baobuibk/NANORACK_V2_PHOTODIODE_1.1.2_HW/03_BOM/NANORACK_PHOTODIODE.xlsx

Comment | Description | Designator | Footprint | LibRef | Quantity
470pF/25V | 0603 | C1, C9, C14 | CN-SMD-0603 | CM | 3
0.22uF/25V | 0603 | C2, C5, C6, C7, C8, C10, C11, C12, C13, C15, C16, C17, C18, C20, C21, C22, C25, C27, C28, C31, C32, C33, C34, C35, C36, C37, C38, C39, C40, C41, C42, C43, C44, C45, C46, C47, C173, C213, C215, C219 | CN-SMD-0603 | CM | 40
10nF/25V | 0603 | C3, C4, C19, C26 | CN-SMD-0603 | CM | 4
100uF 16V | Polarized Capacitor (Axial) | C23, C24 | CAP TANT 2312 | CN-ALU-SMD | 2
100uF/16V | Polarized Capacitor (Axial) | C29, C30 | CAP TANT 2312 | CN-ALU-SMD | 2
10uF 16V | Polarized Capacitor (Axial) | C48, C49, C50 | CAP_TANT_1206 | CN-ALU-SMD | 3
S2312 | TVS DIODE 12VWM 19VC SOT23, P/N: S2312 | D1 | SOT23-123 | S2315 | 1
S2305 | TVS DIODE 5VWM 10.8VC SOT23, P/N: S2305 | D2, D3, D4, D5 | SOT23-123 | S2303 | 4
SS54 | DIODE SCHOTTKY 40V 5A SMA | D6 | DIO-SMD-A | Diode SMD | 1
HOLD |  | H1, H2, H3, H4, H5, H6, H7, H8 | M3 - 6mm | PAD_HOLD | 8
0532610971 | WR-PHD 2.54 mm Angled Socket Header | J1 | 0532610971 | JP9 | 1
Conn shunt | WR-PHD 2.54 mm Angled Socket Header | J2 | M50-3930342 | JP3 | 1
JUMP2 |  | JP1 | Jump2 | JUMP2 | 1
15uH/3.5A | SRP7050TA-150M | L1 | SRP7050TA | INDUCTOR | 1
Photodiode |  | PD1, PD2, PD3, PD4, PD5, PD6, PD7, PD8, PD9, PD10, PD11, PD12, PD13, PD14, PD15, PD16, PD17, PD18, PD19, PD20, PD21, PD22, PD23, PD24, PD25, PD26, PD27, PD28, PD29, PD30, PD31, PD32, PD33, PD34, PD35, PD36 | VEMD5080X01 | Photodiode | 36
330k 1% | 0603 | R1 | RES-SMD-0603 | Res-SMD | 1
10K 1% | 0603 | R2, R4, R6, R24, R26 | RES-SMD-0603 | Res-SMD | 5
4.7K 1% | 0603 | R3, R5, R7, R8, R10, R11, R14, R15, R16, R17, R18, R19, R20, R22, R23 | RES-SMD-0603 | Res-SMD | 15
51R 1% | 0603 | R9 | RES-SMD-0603 | Res-SMD | 1
22R 1% | 0603 | R12, R13 | RES-SMD-0603 | Res-SMD | 2
3.24K 0.1% | ERA-3AEB3241V | R25 | RES-SMD-0603 | Res-SMD | 1
2K 1% | 0603 | R27 | RES-SMD-0603 | Res-SMD | 1
Test_Point |  | TP1, TP2, TP3, TP4, TP6, TP7, TP8, TP9, TP10, TP11, TP12, TP13 | TESTPOINT | Test_Point | 12
ADG1414BCPZ | IC SW SPST-NOX8 11.5OHM 24LFCSP | U1, U2, U5, U6, U7, U8 | ADG1414BCPZ | ADG1414 | 6
OPA4340 | IC CMOS 4 CIRCUIT 16SSOP | U3 | SSOP16 | OPA4340 | 1
REF1930 | REF1941AIDDCT | U4 | SOT23-5 | REF19xx | 1
TPS5430DDAR | 8SOP | U9 | HSOP8 | TPS543X | 1
ADS8327 | IC ADC 16BIT SAR 16TSSOP | U10 | TSSOP16 | ADS8327 | 1
ICL7660 | CMOS Voltage Converters | U11 | SO8 | ICL7660 | 1
TPS7A4533DCQR | IC REG LINEAR 3.3V 1.5A SOT223-6 | U12 | SOT223-6 | TPS7A4533DCQR | 1
