baobuibk/NANORACK_V2_PHOTODIODE_1.1.2_HW/03_BOM/PHOTODIODE_BOM_V1.2.0.xlsx

Name/Comment | Description | Designator | Footprint | Manufacturer | Manufacturer P/N | Quantity | NOTE | STATUS
10uF/16V | CAP TANT 10UF 10% 16V 1206 | C48, C49, C50 | 1206 | KYOCERA AVX | TAJA106K016RNJ | 3
100uF/16V | CAP TANT 100UF 10% 16V 2312 | C23, C24, C29, C30 | 2312 | KYOCERA AVX | TAJC107K016RNJ | 4
10nF/16V | CAP CER 10NF 16V X7R 0603 | C3, C4, C19, C26 | SM-0603 | Samsung Electro-Mechanics | CL10B103KO8WPNC | 4
470pF/50V | CAP CER 470PF 50V X7R 0603 | C1, C9, C14 | SM-0603 | Samsung Electro-Mechanics | CL10B471KB8NNNC | 3
0.22uF 25V | CAP CER 0.22UF 25V X7R 0603 | C2, C5, C6, C7, C8, C10, C11, C12, C13, C15, C16, C17, C18, C20, C21, C22, C25, C27, C28, C31, C32, C33, C34, C35, C36, C37, C38, C39, C40, C41, C42, C43, C44, C45, C46, C47, C173, C213, C215, C219 | SM-0604 | Samsung Electro-Mechanics | CL10B224KO8NNNC | 40
OPA4340 | IC CMOS 4 CIRCUIT 16SSOP | U3 | SSOP16 | Texas Instruments | OPA4340EA/2K5 | 1
REF1930 | IC VREF SERIES 0.1% SOT23-5 | U4 | SOT23-5 | Texas Instruments | REF1930AIDDCT | 1
ADS8327 | IC ADC 16BIT SAR 16TSSOP | U10 | TSSOP16 | Texas Instruments | ADS8327IPW | 1
Photodiode | SENSOR PHOTODIODE 950NM 4SMD | PD1, PD2, PD3, PD4, PD5, PD6, PD7, PD8, PD9, PD10, PD11, PD12, PD13, PD14, PD15, PD16, PD17, PD18, PD19, PD20, PD21, PD22, PD23, PD24, PD25, PD26, PD27, PD28, PD29, PD30, PD31, PD32, PD33, PD34, PD35, PD36 | PS13-6B TO | Vishay Semiconductor Opto Division | VEMD5080X01 | 36
330k 1% | RES SMD 330K OHM 1% 1/10W 0603 | R1 | RES-SMD-0603 | Panasonic Electronic Components | ERJ-3EKF3303V | 1
51R 1% | RES SMD 51 OHM 1% 1/10W 0603 | R9 | RES-SMD-0603 | Panasonic Electronic Components | ERJ-3EKF51R0V | 1
4.7k 1% | RES SMD 4.7K OHM 1% 1/10W 0603 | R3, R5, R7, R8, R10, R11, R14, R15, R16, R17, R18, R19, R20, R22, R23 | RES-SMD-0603 | Panasonic Electronic Components | ERJ-3EKF4701V | 15
10K 1% | RES SMD 10K OHM 1% 1/10W 0603 | R2, R4, R6, R24, R26 | RES-SMD-0603 | Panasonic Electronic Components | ERJ-3EKF1002V | 5
22R 1% | RES SMD 22 OHM 1% 1/10W 0603 | R12, R13 | RES-SMD-0603 | Panasonic Electronic Components | ERJ-3EKF22R0V | 2
2K 1% | RES SMD 2K OHM 1% 1/10W 0603 | R27 | RES-SMD-0603 | Panasonic Electronic Components | ERJ-3EKF2001V | 1
S2312 | TVS DIODE 12VWM 19VC SOT23 | D1 | SOT23-123 | SMC Diode Solutions | S2312 | 1
S2303 | TVS DIODE 5VWM 8VC SOT23, P/N: S2303 | D2, D3, D4, D5 | SOT23-123 | SMC Diode Solutions | S2303 | 4
TPS7A4533DCQR | IC REG LINEAR 3.3V 1.5A SOT223-6 | U12 | SOT223 | Texas Instruments | TPS7A4533DCQR | 1
SS54 | DIODE SCHOTTKY 40V 5A SMA | D6 | DIO-SMD-A | EVVO | SS54 | 1
15uH/3.5A | FIXED IND 15UH 3.5A 92 MOHM SMD | L1 | SRP7050TA | Bourns Inc. | SRP7050TA-150M | 1
3.24K 0.1% | RES SMD 3.24K OHM 1% 1/10W 0603 | R25 | RES-SMD-0603 | Panasonic Electronic Components | ERJ-3EKF3241V | 1
ADG1414BCPZ | IC SW SPST-NOX8 11.5OHM 24LFCSP | U1, U2, U5, U6, U7, U8 | ADG1414BCPZ | Analog Devices Inc. | ADG1414BCPZ | 6
TPS5430DDAR | IC REG BUCK ADJ 3A 8SOPWR | U9 | HSOP8 | Texas Instruments | TPS5430DDAR | 1
CONNECTOR | CONN HEADER SMD R/A 9POS 1.25MM | J1 | JP9 | Molex | 0532610971 | 1
CONN_SHUNT | CONN HEADER R/A 3POS 1.27MM | J2 |  | Harwin Inc. | M50-3930342 | 1
ICL7660 | IC REG CHARG PUMP INV 45MA 8SOIC | U11 | SO8 | Renesas Electronics Corporation | ICL7660ACBAZA-T | 1
M50-1900005 | CONN SHUNT 1.27MM BLACK |  |  | Harwin Inc. | M50-1900005 | 1 | Mating
0510210900 | CONN RCPT HSG 9POS 1.25MM |  |  | Molex | 0510210900 | 1 | Mating for J1
0500798000 | CONN SOCKET 26-28AWG CRIMP TIN |  |  | Molex | 0500798000 | 9 | Cos for mating J1
 |  |  |  |  |  | 137
