baobuibk/NANORACK_V2_PHOTODIODE_1.1.2_HW/02_SCHEMATIC_PDF/NANORACK_PHOTODIODE.pdf

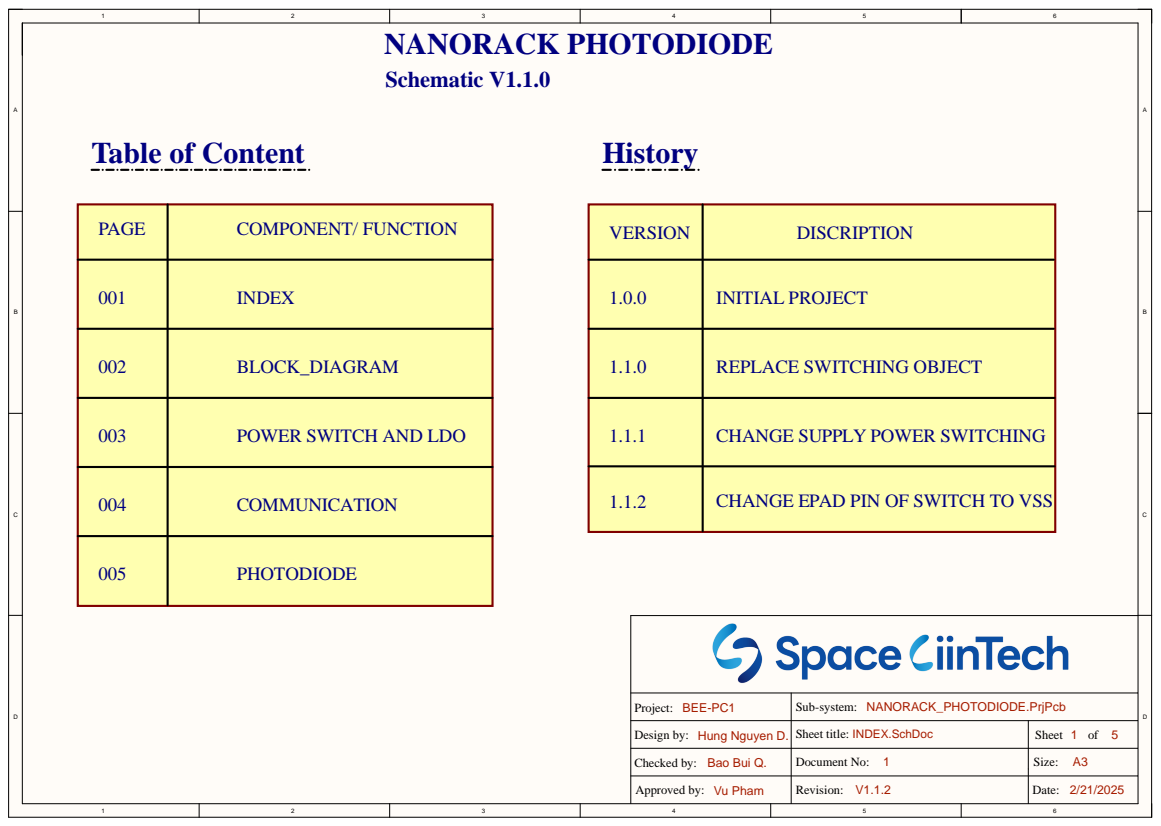
[picture p1: page 1]

POWER SWITCH AND LDO

CHANGE SUPPLY POWER SWITCHING

Project: BEE-PC1 | NANORACK_PHOTODIODE.PrjPcb Sub-system:

Design by: Hung Nguyen D. | Sheet title: INDEX.SchDoc | Sheet 1 of 5

Checked by: Bao Bui Q. | Document No: 1 | Size: A3

Approved by: Vu Pham | Revision: V1.1.2 | Date: 2/21/2025

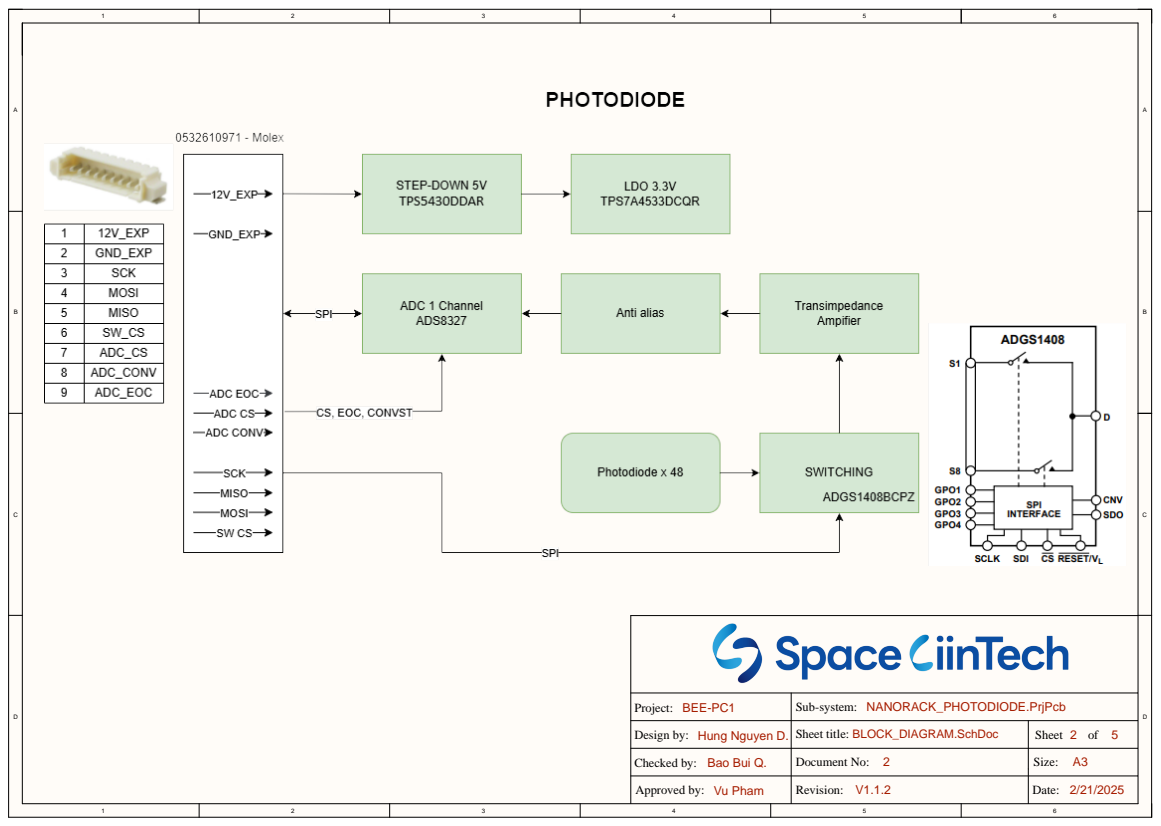
[picture p2: page 2]

Project: BEE-PC1 | NANORACK_PHOTODIODE.PrjPcb Sub-system:

Design by: Hung Nguyen D. | Sheet title: BLOCK_DIAGRAM.SchDoc | Sheet 2 of 5

Checked by: Bao Bui Q. | Document No: 2 | Size: A3

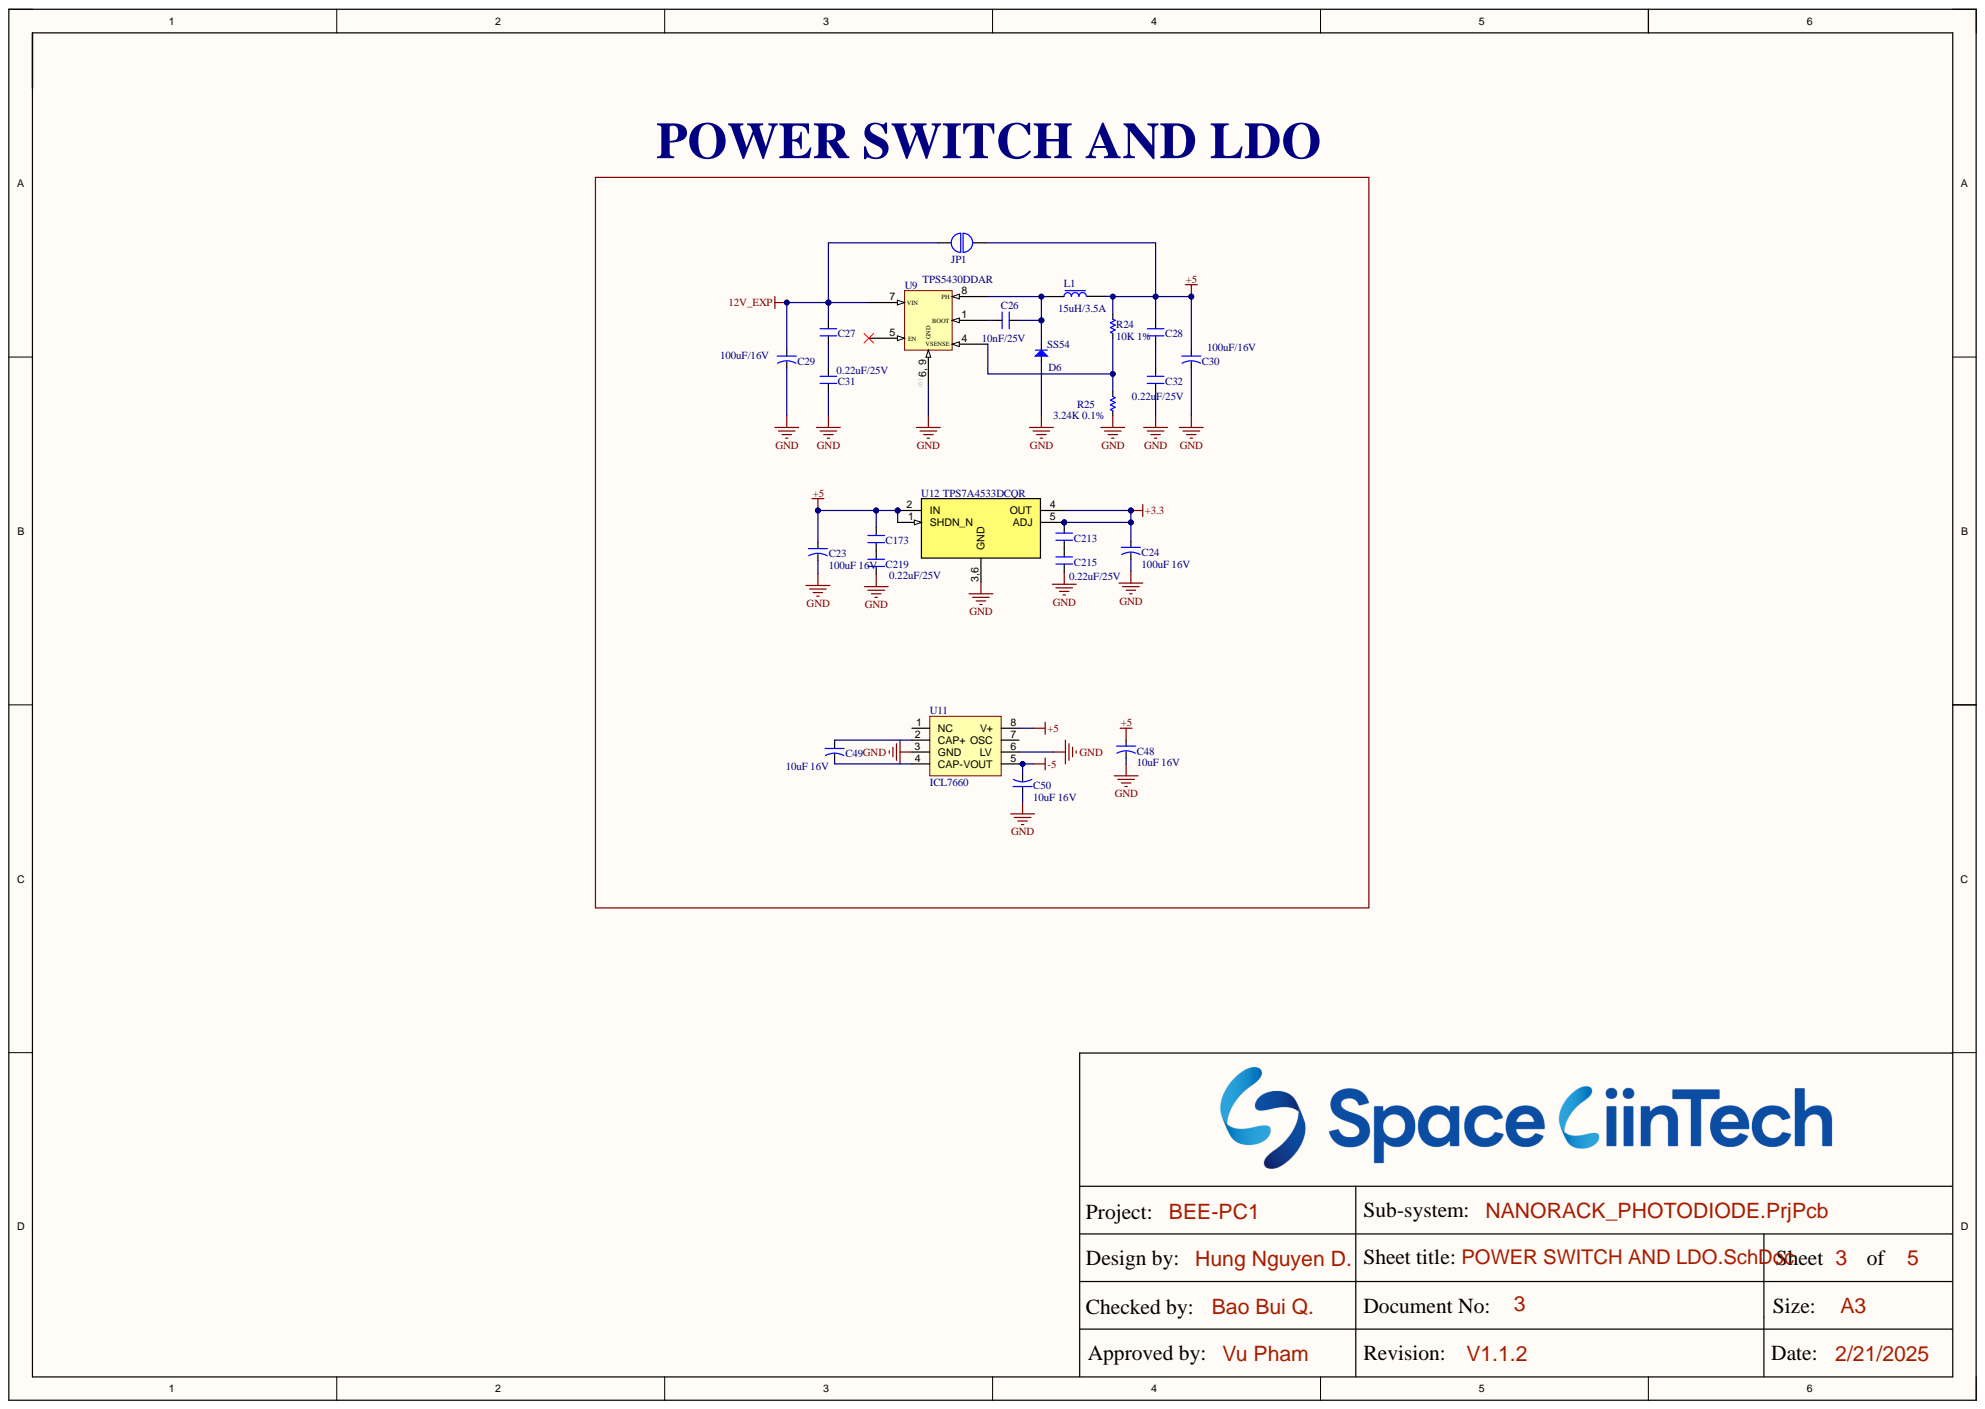
[picture p3: page 3]

POWER SWITCH AND LDO

Project: BEE-PC1 | NANORACK_PHOTODIODE.PrjPcb Sub-system:

Design by: Hung Nguyen D. | Sheet title: POWER SWITCH AND LDO.SchDoc | Sheet 3 of 5

Checked by: Bao Bui Q. | Document No: 3 | Size: A3

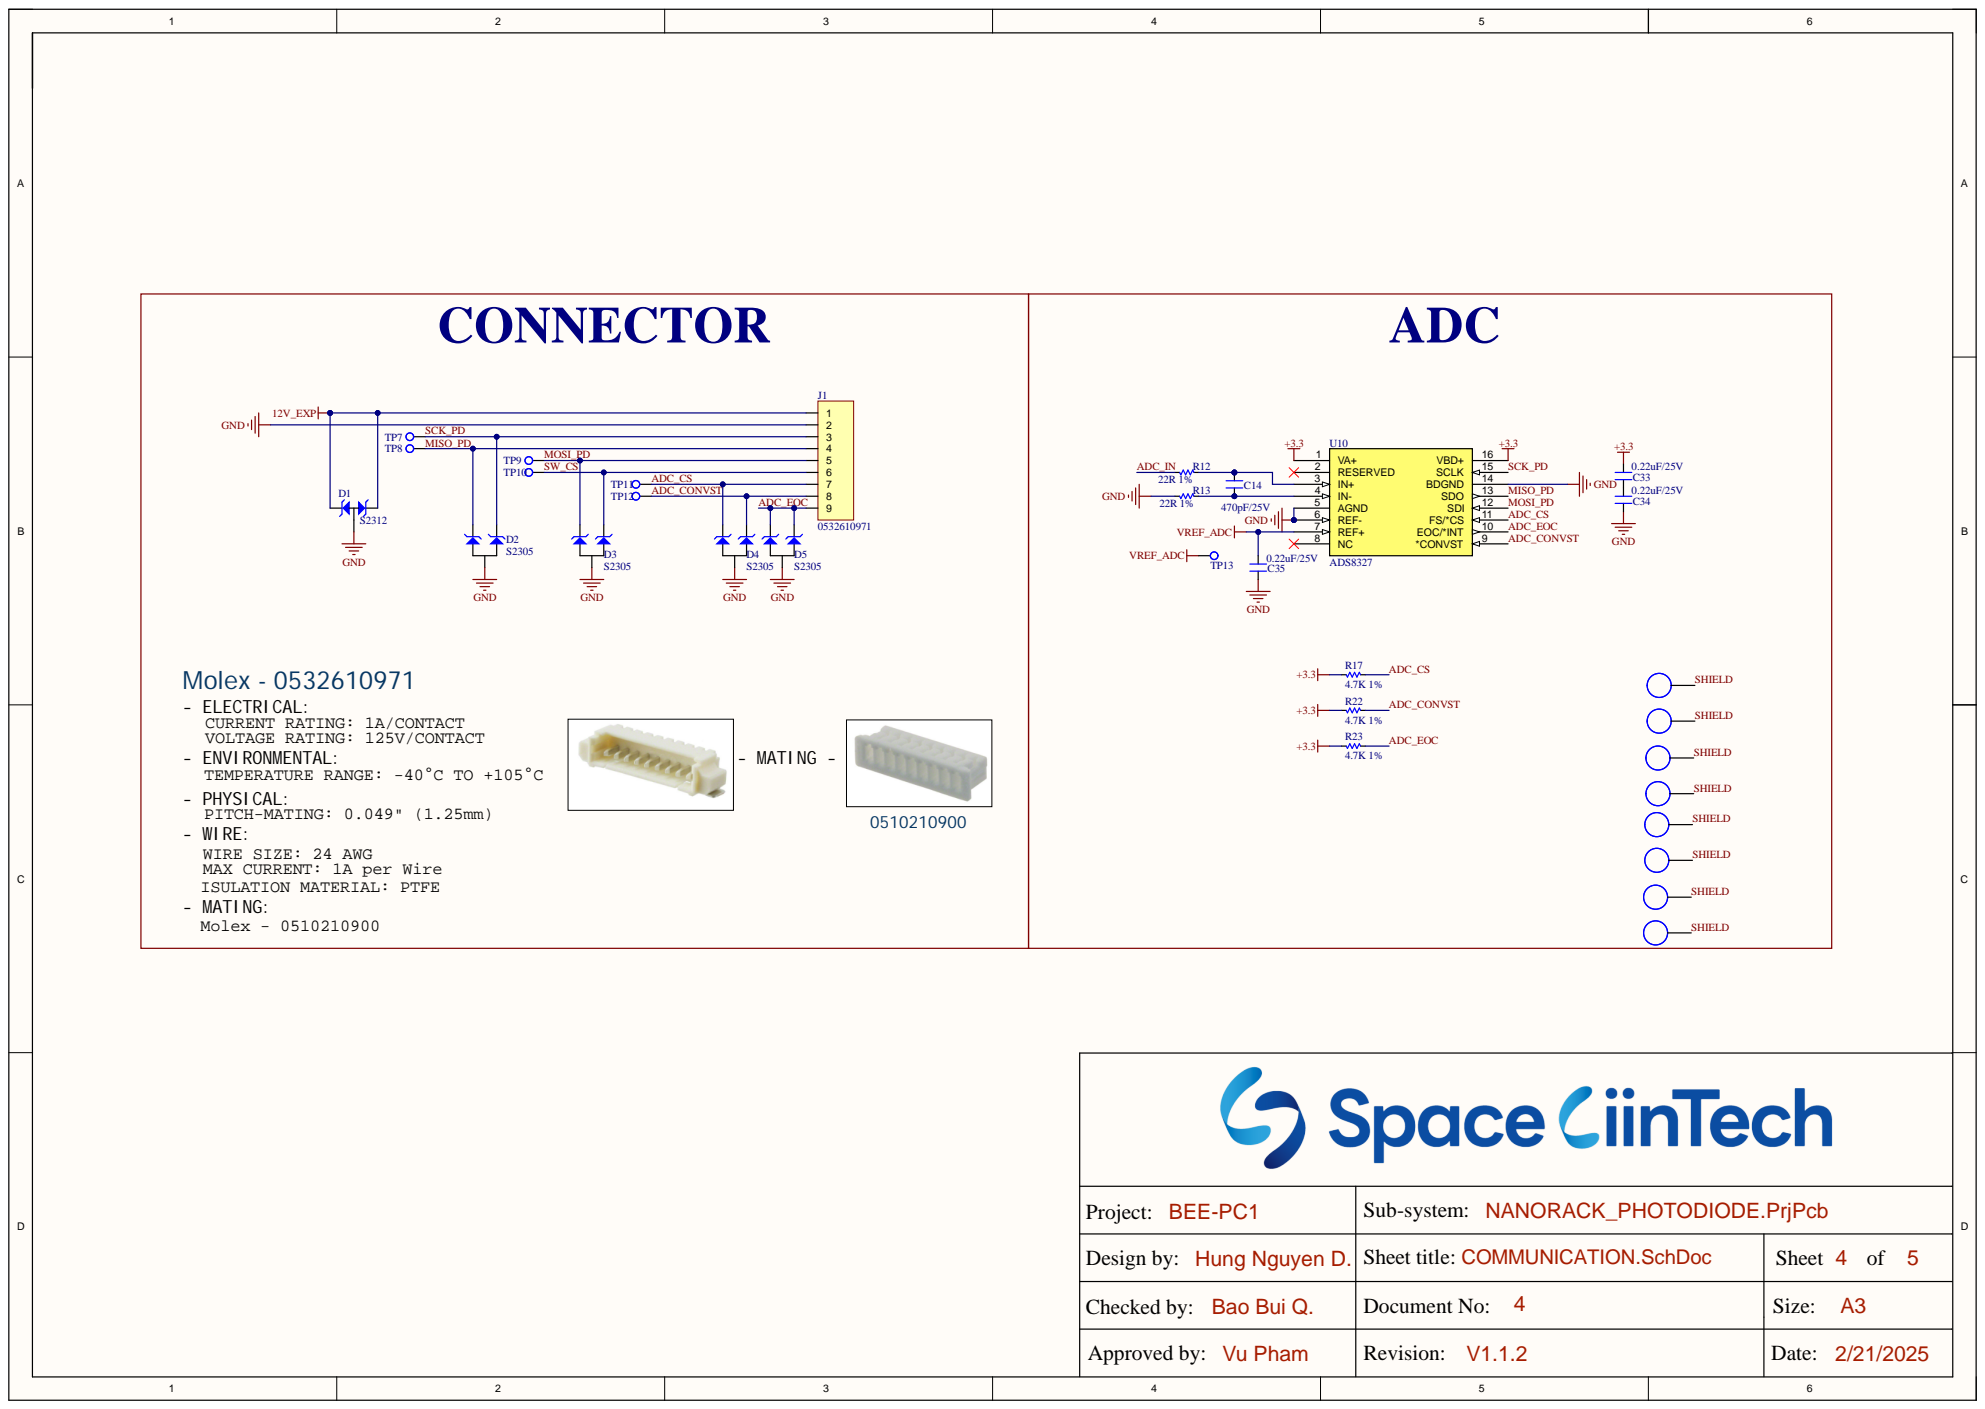
[picture p4: page 4]

- ELECTRICAL: CURRENT RATING: 1A/CONTACT VOLTAGE RATING: 125V/CONTACT

- ENVIRONMENTAL: TEMPERATURE RANGE: -40°C TO +105°C

WIRE SIZE: 24 AWG MAX CURRENT: 1A per Wire

Project: BEE-PC1 | NANORACK_PHOTODIODE.PrjPcb Sub-system:

Design by: Hung Nguyen D. | Sheet title: COMMUNICATION.SchDoc | Sheet 4 of 5

Checked by: Bao Bui Q. | Document No: 4 | Size: A3

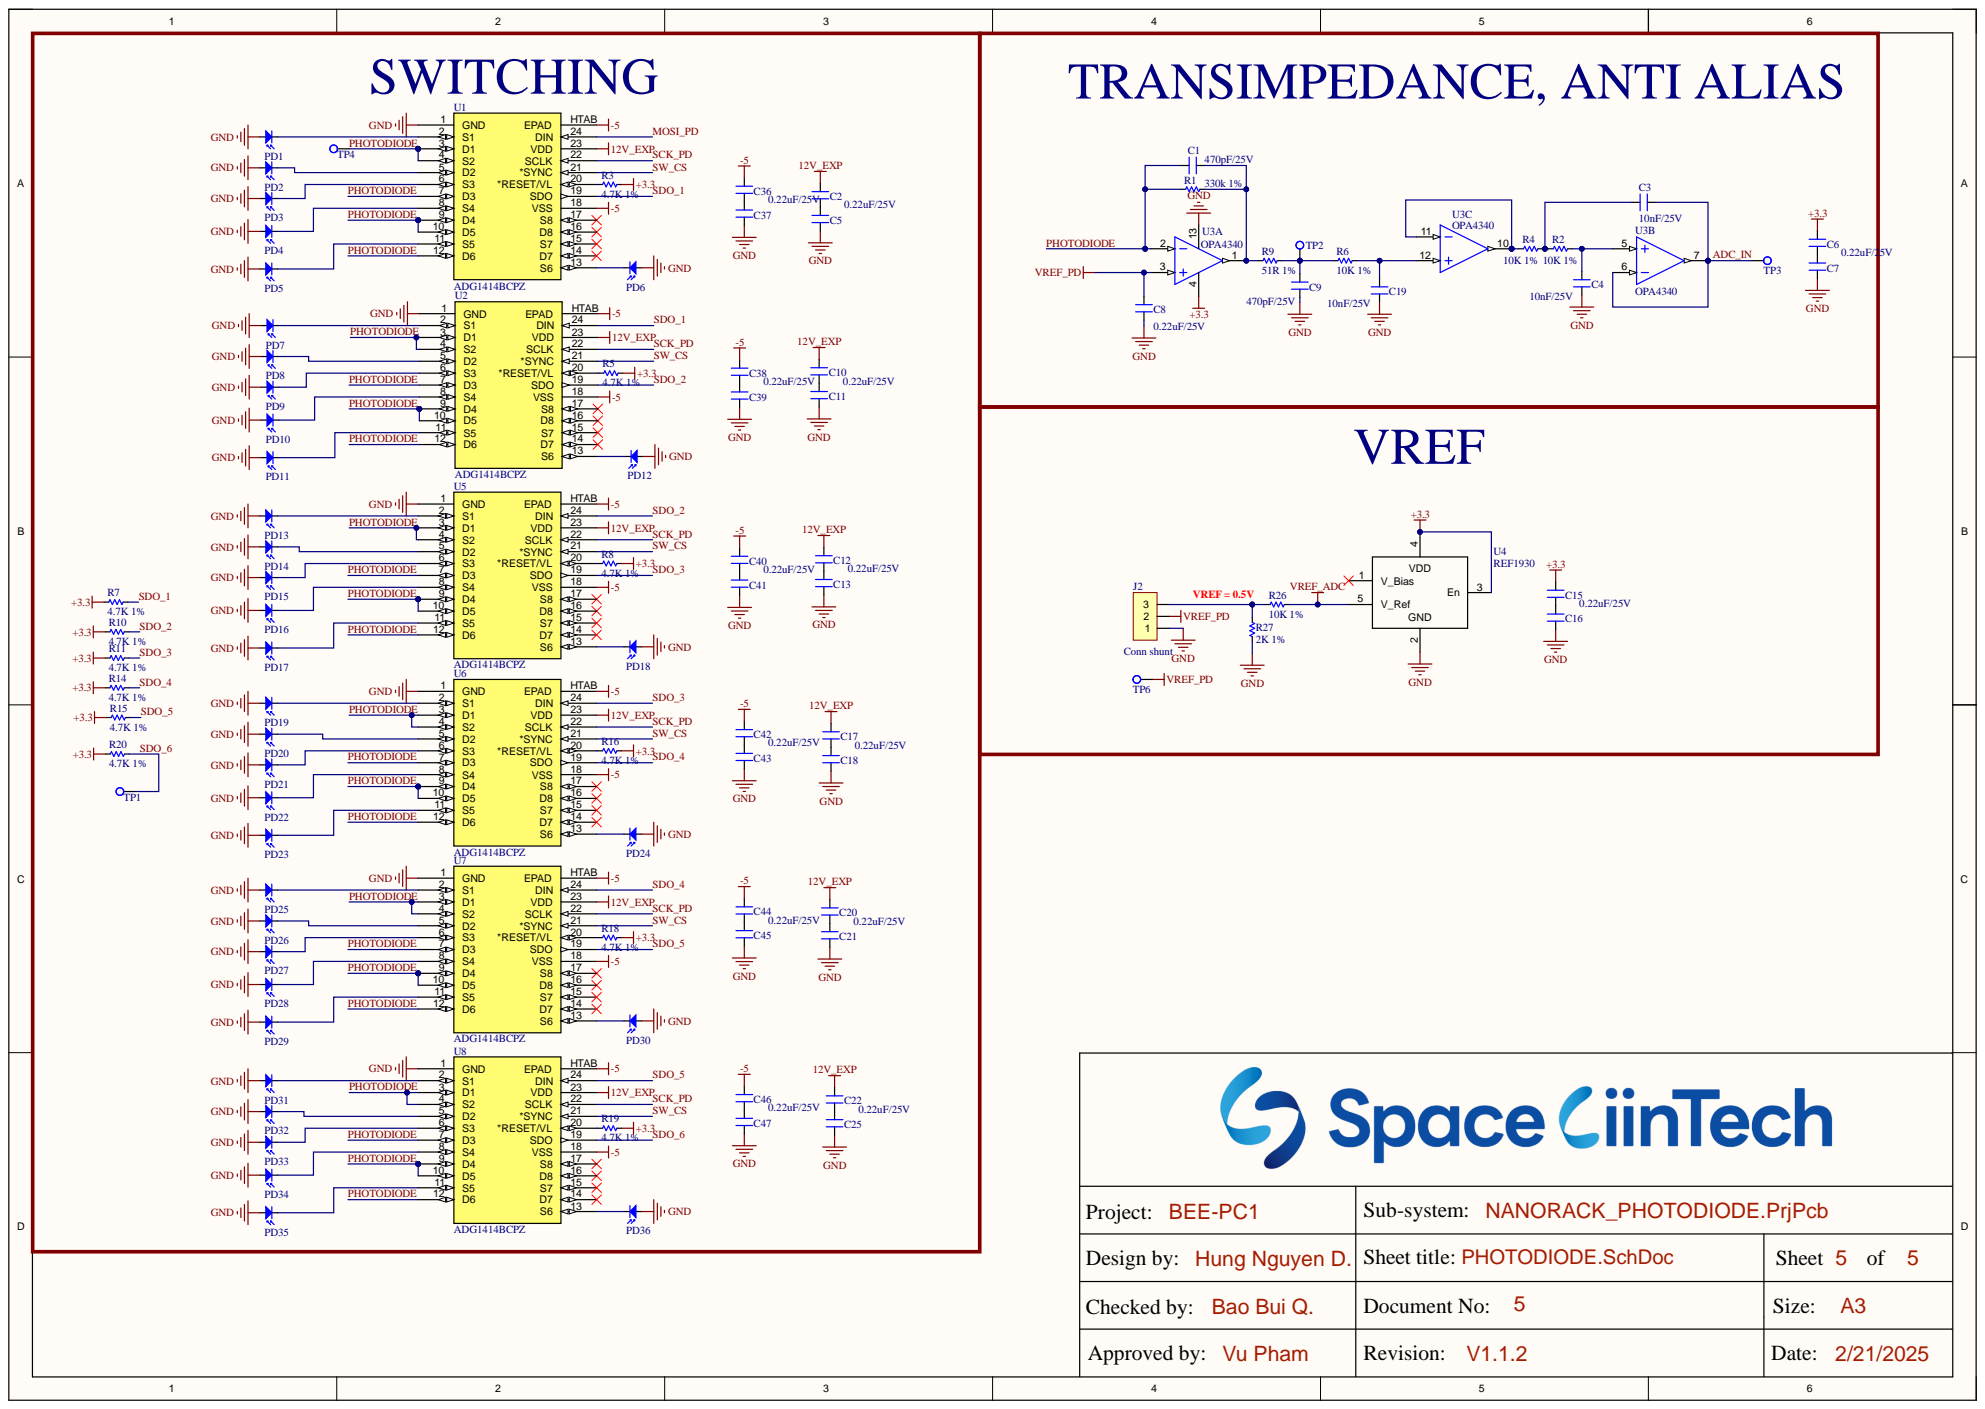
[picture p5: page 5]

Design by: Hung Nguyen D. | Sheet title: PHOTODIODE.SchD o c | Sheet 5 of 5

Checked by: Bao Bui Q. Vu Pham | Document No: V1.1.25 | Size: A3
