baobuibk/NANORACK_V2_PHOTODIODE_1.1.2_HW/05_SMT/ASM_NANORACK_PHOTODIODE.pdf

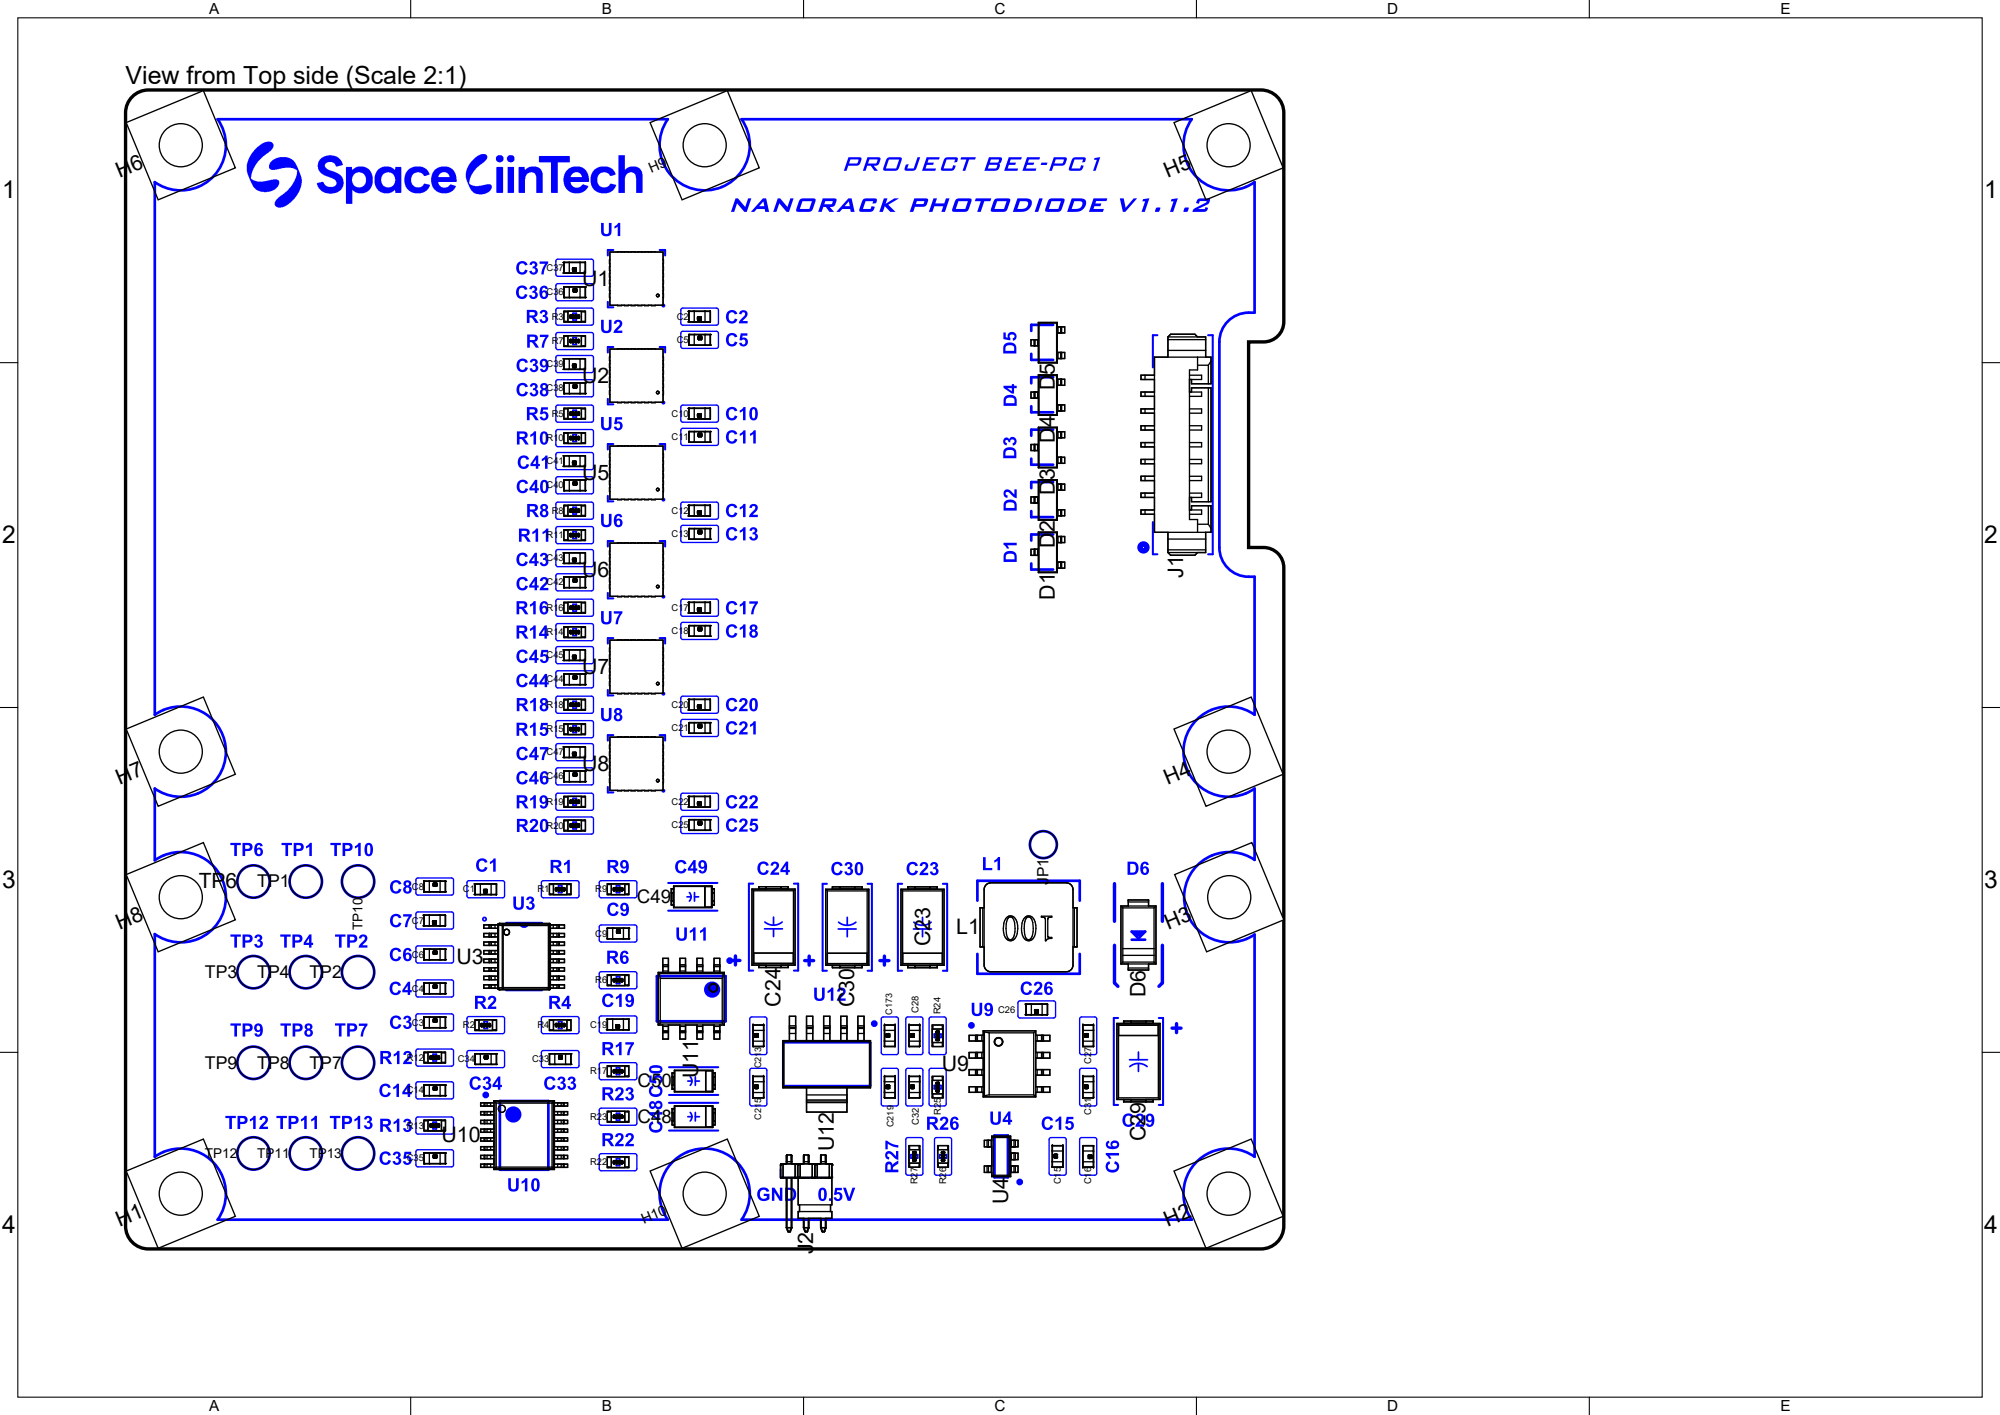
[picture p6: page 1]

View from Top side (Scale 2:1)

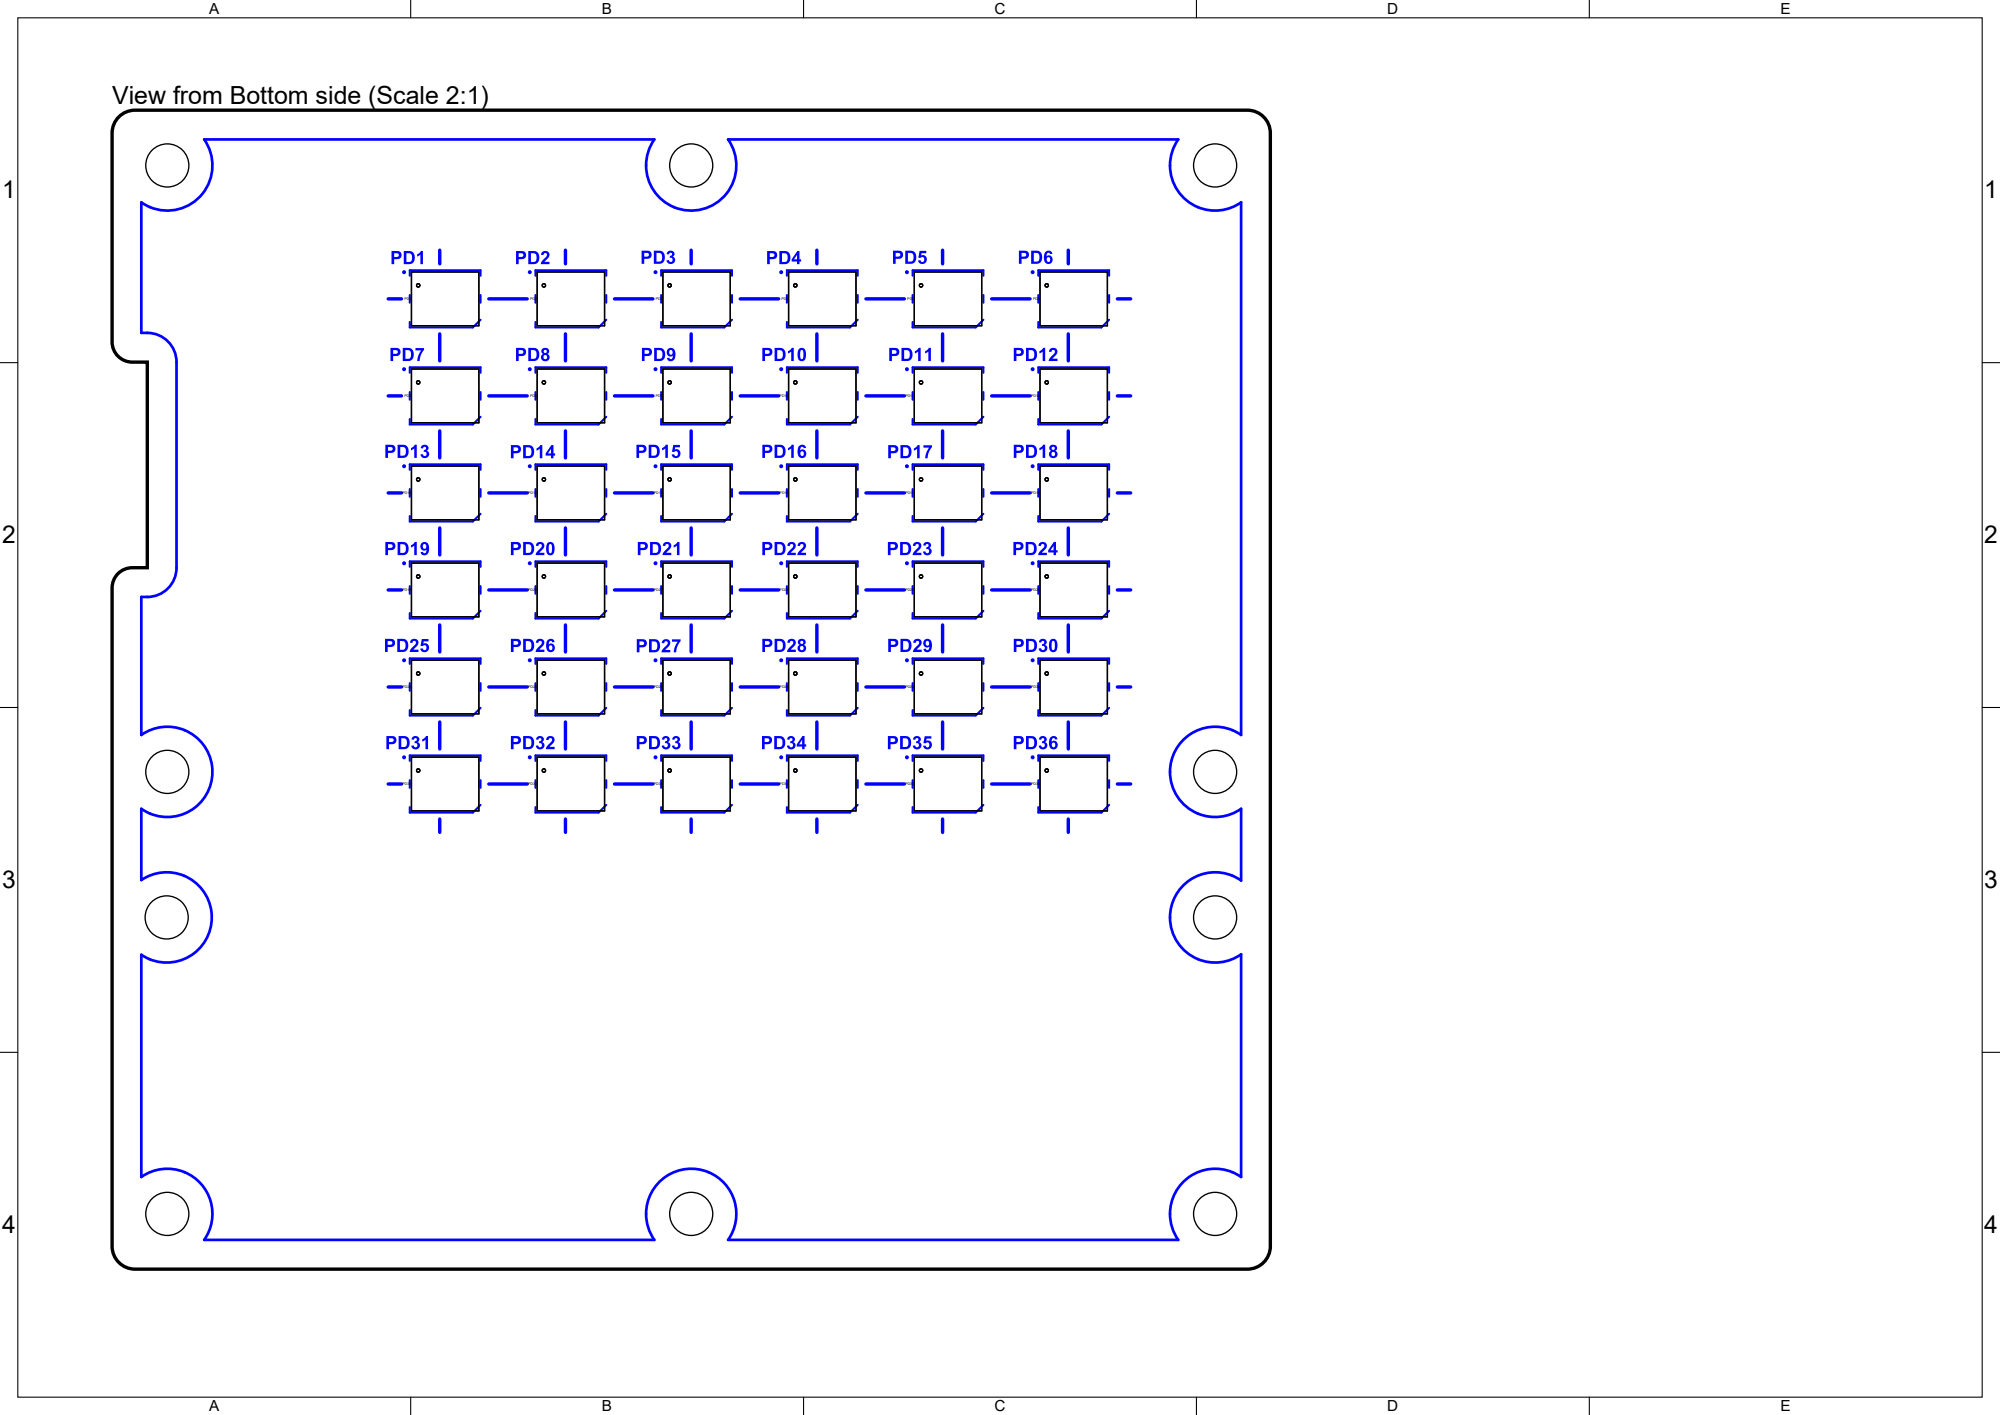
[picture p7: page 2]

View from Bottom side (Scale 2:1)

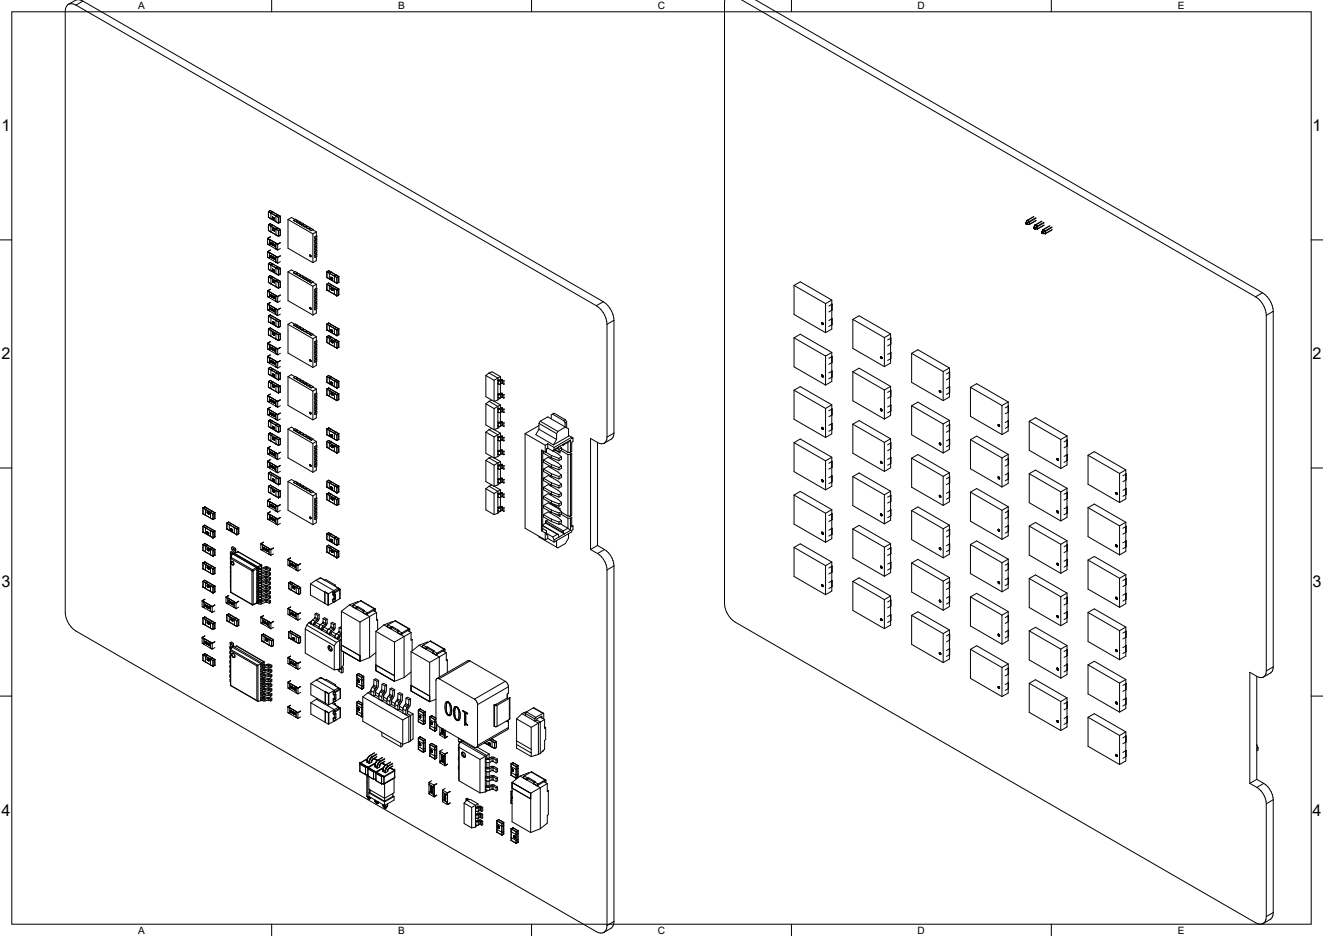
[picture p8: page 3]
