baobuibk/NANORACK_V2_PHOTODIODE_1.1.2_HW/(list of files, drawings)

Other design files:
01_DESIGN/BLOCK_DIAGRAM.SchDoc
01_DESIGN/COMMUNICATION.SchDoc
01_DESIGN/INDEX.SchDoc
01_DESIGN/NANORACK_PHOTODIODE.PrjPcb
01_DESIGN/PHOTODIODE.SchDoc
01_DESIGN/POWER SWITCH AND LDO.SchDoc
