baobuibk/NANORACK_V2_PHOTODIODE_1.1.2_HW/(commit log)

2025-04-09 Ver112: create gerber file
    [COMMUNICATION.SchDoc, NANORACK_PHOTODIODE.PrjPcb, NANORACK_PHOTODIODE.xlsx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]
2025-04-10 Ver120: adjust version name
    [BLOCK_DIAGRAM.SchDoc, COMMUNICATION.SchDoc, INDEX.SchDoc, NANORACK_PHOTODIODE.PrjPcb, PHOTODIODE.SchDoc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]
2025-04-14 Ver120: adjust hole position
    [NANORACK_PHOTODIODE.PrjPcb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]
